Abhijit123Gupta/Smart_Helmet/Code/fall_detection_interrupt.ino

#include<Wire.h>
#include "I2Cdev.h"     //For communicate with MPU6050
#include "MPU6050.h"    //The main library of the MPU6050

const int MPU_addr = 0x68; // I2C address of the MPU-6050
int16_t AcX, AcY, AcZ, Tmp, GyX, GyY, GyZ;
float ax = 0, ay = 0, az = 0, gx = 0, gy = 0, gz = 0;

MPU6050 mpu;
int16_t aax, aay, aaz;
int16_t ggx, ggy, ggz;


//void ICACHE_RAM_ATTR alcsens();
void ICACHE_RAM_ATTR soundsens();


//volatile int alc = 14; //D5
volatile int s = 13;//D7
//volatile int alc_int = 12; //D6
volatile int s_int = 15; //D8
uint8_t acci = 0; //D3


boolean fall = false; //stores if a fall has occurred
boolean trigger1 = false; //stores if first trigger (lower threshold) has occurred
boolean trigger2 = false; //stores if second trigger (upper threshold) has occurred
boolean trigger3 = false; //stores if third trigger (orientation change) has occurred

byte trigger1count = 0; //stores the counts past since trigger 1 was set true
byte trigger2count = 0; //stores the counts past since trigger 2 was set true
byte trigger3count = 0; //stores the counts past since trigger 3 was set true
int angleChange = 0;


void setup() {
  Wire.begin();
  Wire.beginTransmission(MPU_addr);
  Wire.write(0x6B);  // PWR_MGMT_1 register
  Wire.write(0);     // set to zero (wakes up the MPU-6050)
  Wire.endTransmission(true);
  Serial.begin(9600);

  pinMode(alc_int, OUTPUT);
  pinMode(s_int, OUTPUT);
  pinMode(acci, OUTPUT);
  pinMode(alc, INPUT_PULLUP);
  pinMode(s, INPUT_PULLUP);

  mpu.initialize();
  attachInterrupt(digitalPinToInterrupt(s), soundsens, RISING);




}
void loop() {

  mpu.getMotion6(&aax, &aay, &aaz, &ggx, &ggy, &ggz);
  data[0] = map(ax, -17000, 17000, 300, 400 );
  data[1] = map(ay, -17000, 17000, 100, 200);

  mpu_read();
  //2050, 77, 1947 are values for calibration of accelerometer
  // values may be different for you
  ax = (AcX + 1616) / 16384.00;
  ay = (AcY + 1004) / 16384.00;
  az = (AcZ - 17876) / 16384.00;

  `
  //270, 351, 136 for gyroscope
  gx = (GyX - 91) / 131.07;
  gy = (GyY - 89) / 131.07;
  gz = (GyZ - 542) / 131.07;

  // calculating Amplitute vactor for 3 axis
  float Raw_AM = pow(pow(ax, 2) + pow(ay, 2) + pow(az, 2), 0.5);
  int AM = Raw_AM * 10;  // as values are within 0 to 1, I multiplied

  // Direction
  if (AM > 4)
  {
    if (data[0] > 375)
      Serial.println("Forward");

    if (data[0] < 340)
      Serial.println("Backward");


    if (data[1] > 145)
      Serial.println("Left");

    if (data[1] < 135)
      Serial.println("Right");

    delay(200);
  }



  if (trigger3 == true) {
    trigger3count++;
    //Serial.println(trigger3count);
    if (trigger3count >= 10) {
      angleChange = pow(pow(gx, 2) + pow(gy, 2) + pow(gz, 2), 0.5);
      //delay(10);
      Serial.println(angleChange);
      if ((angleChange >= 0) && (angleChange <= 10)) { //if orientation changes remains between 0-10 degrees
        fall = true; trigger3 = false; trigger3count = 0;
        Serial.println(angleChange);
      }
      else { //user regained normal orientation
        trigger3 = false; trigger3count = 0;
        Serial.println("TRIGGER 3 DEACTIVATED");
      }
    }
  }
  if (fall == true) { //in event of a fall detection
    Serial.println("FALL DETECTED");

    for (int i = 0; i < 5; i++)
    {
      digitalWrite(acci, LOW);
      delay(200);
      digitalWrite(acci, HIGH);
      delay(200);
    }

    fall = false;
    // exit(1);
  }
  if (trigger2count >= 6) { //allow 0.5s for orientation change
    trigger2 = false; trigger2count = 0;
    Serial.println("TRIGGER 2 DECACTIVATED");
  }
  if (trigger1count >= 6) { //allow 0.5s for AM to break upper threshold
    trigger1 = false; trigger1count = 0;
    Serial.println("TRIGGER 1 DECACTIVATED");
  }
  if (trigger2 == true) {
    trigger2count++;
    //angleChange=acos(((double)x*(double)bx+(double)y*(double)by+(double)z*(double)bz)/(double)AM/(double)BM);
    angleChange = pow(pow(gx, 2) + pow(gy, 2) + pow(gz, 2), 0.5); Serial.println(angleChange);
    if (angleChange >= 30 && angleChange <= 400) { //if orientation changes by between 80-100 degrees
      trigger3 = true; trigger2 = false; trigger2count = 0;
      Serial.println(angleChange);
      Serial.println("TRIGGER 3 ACTIVATED");
    }
  }
  if (trigger1 == true) {
    trigger1count++;
    if (AM >= 12) { //if AM breaks upper threshold (3g)
      trigger2 = true;
      Serial.println("TRIGGER 2 ACTIVATED");
      trigger1 = false; trigger1count = 0;
    }
  }
  if (AM <= 2 && trigger2 == false) { //if AM breaks lower threshold (0.4g)
    trigger1 = true;
    Serial.println("TRIGGER 1 ACTIVATED");
  }
  //It appears that delay is needed in order not to clog the port
  delay(100);
}

void mpu_read() {
  Wire.beginTransmission(MPU_addr);
  Wire.write(0x3B);  // starting with register 0x3B (ACCEL_XOUT_H)
  Wire.endTransmission(false);
  Wire.requestFrom(MPU_addr, 14, true); // request a total of 14 registers
  AcX = Wire.read() << 8 | Wire.read(); // 0x3B (ACCEL_XOUT_H) & 0x3C (ACCEL_XOUT_L)
  AcY = Wire.read() << 8 | Wire.read(); // 0x3D (ACCEL_YOUT_H) & 0x3E (ACCEL_YOUT_L)
  AcZ = Wire.read() << 8 | Wire.read(); // 0x3F (ACCEL_ZOUT_H) & 0x40 (ACCEL_ZOUT_L)
  Tmp = Wire.read() << 8 | Wire.read(); // 0x41 (TEMP_OUT_H) & 0x42 (TEMP_OUT_L)
  GyX = Wire.read() << 8 | Wire.read(); // 0x43 (GYRO_XOUT_H) & 0x44 (GYRO_XOUT_L)
  GyY = Wire.read() << 8 | Wire.read(); // 0x45 (GYRO_YOUT_H) & 0x46 (GYRO_YOUT_L)
  GyZ = Wire.read() << 8 | Wire.read(); // 0x47 (GYRO_ZOUT_H) & 0x48 (GYRO_ZOUT_L)

}

void soundsens()
{
  long timer;
  timer = millis();
  while ((millis() - timer) < 500)
    digitalWrite(s_int, HIGH  );
  digitalWrite(s_int, LOW);
}
